BowenS123/2EAI-PEN-2526-Industry4/hardware/README.md

> [!Tip]
>
> Plaats hier **schema's, PCB's en BoM's**.
>
> Structuur: `schematics/`, `pcb/`, `bom/`, `3d/`.
>
> Noem gebruikte tools (bijv. KiCad, Eagle) in een README binnen deze map.

# Hardwareoverzicht

Dit document bevat een overzicht van de gebruikte hardwarecomponenten in dit project. Alle datasheets zijn lokaal opgeslagen in de map `../docs/datasheets/`.

## 🧩 Componentenlijst

| Componentnaam  | Functie | Fabrikant | Datasheet | More info | Supplier |
|---|---|---|---|---|---|
| VL53L0X | Afstandssensor | STMicroelectronics | [Datasheets](../docs/datasheets/) | [wiki.st.com]| [mouser]( ) |
| NEMA 17 | Stappenmotor | -- | [Datasheets](../docs/datasheets/) | -- | [mouser]( ) |
| ESP32 DevKit | Microcontroller | Espressif | [Datasheets](../docs/datasheets/) | [docs.espressif.com]() | [mouser]( ) |

## 🔌 Aansluitschema

> Voeg hier een afbeelding of diagram toe waarin de bedrading en verbindingen van de componenten worden weergegeven.

- Bestand: `./schematics/wiringschema.png`
- Alternatief: teken met [Fritzing] en exporteer als PNG/SVG.

## 📏 Specificaties en toleranties

- Voedingsspanning: 5V via USB
- Motorstroom: max. 1.2A
- Sensorbereik: 20 mm – 2000 mm (VL53L0X)
- Communicatie: I²C (3.3V-logica)

## 📦 Reserve-onderdelen en versies

- Kalibratie uitgevoerd met firmwareversie `v1.0.3`.
- ESP32 DevKit V4 (let op: oudere versies hebben andere pinout).
