BowenS123/2EAI-PEN-2526-Industry4/docs/Report turning cilinder.pdf

# Turning Modular actuator

Modular cilinder basics
Cilinder: Static Base cilinder: 40 mm diameter, 5 mm depth Cilinder: HoleStatic 25 mm diameter, 5 mm depth

// join => Staticcilinder
————————————————————————————————— StepMotor fit
Cube: StepMaxDim: width 32.1, height 22.2, depth 12.2

StepBody: Join ConnectStep & MainBodyStep : CTR+J-key => StepBody Cube: MainBodyStep: width 23, height: 22.2, depth 12.2
Cube: ConnectStep: width 32.1, height 3, depth 12.2
// connectstep 18.2 <-> 21.2 into height main body
// blender calc begin ConnectStep => 18.2/2 - 3/2 = 9.1-1.5 = 7.6 Print this to compare to stepmotor

Cilinder main
copy Staticcilinder => MotorCilinder
Pas aan properties: diameter 25 mm, hoogte 20 mm

Splits MotorCilinder in 2: Boolean delete + copy Connectie 2 objecten:
- Clilinder 1: delete
- Cilinder 2: join
Ruimte voor servo:
1. Zet alles op juiste plaats
2. Op elk opject dat servo raakt: delete boolean
