BowenS123/2EAI-PEN-2526-Industry4/docs/README.md

# Projectdocumentatie

Deze map bevat de technische documentatie, diagrammen, handleidingen,
datasheets en afbeeldingen van de Industry 4.0-installatie.

## Belangrijkste documenten

- [MQTT instellen en testen](MOSQUITTO_SETUP.md)
- [TwinCAT Vision installeren](InstallatieTCVision.md)
- [PLC-documentatie](PLC_Documentatie.md)
- [Onderdelenlijst](Bomlijst.md)
- [Bijdragen aan het project](CONTRIBUTING.md)

## Media

- `images/0_HardwareDiagram.png` — hardwarearchitectuur
- `images/0_Final_Result.drawio.png` — systeemoverzicht
- `images/Testcamera.png` — werkende QR-detectie

Gebruik in Markdown altijd relatieve paden. Nieuwe afbeeldingen krijgen een
beschrijvende naam en worden toegevoegd aan een relevante documentatiepagina.
Build-output, tijdelijke exports en persoonlijke credentials horen niet in Git.
