BowenS123/2EAI-PEN-2526-Industry4/firmware/README.md

# Firmware

De actieve firmwareprojecten staan gegroepeerd onder [`src/`](../src/):

- [`ESP_Mixer_MQTT`](../src/ESP_Mixer_MQTT/) — ESP32/PlatformIO-mixer
- [`PSOC_MQTT`](../src/PSOC_MQTT/) — PSoC6 MQTT-client
- [`RobotArm`](../src/RobotArm/) — PSoC6-robotarm en teach mode

Open elk project met de bijbehorende toolchain. Gebruik lokale configuratie-
bestanden voor WiFi- en MQTT-credentials; commit nooit echte wachtwoorden.
