BowenS123/2EAI-PEN-2526-Industry4/hardware/3Dprint/Transportband/doosje_transport.png

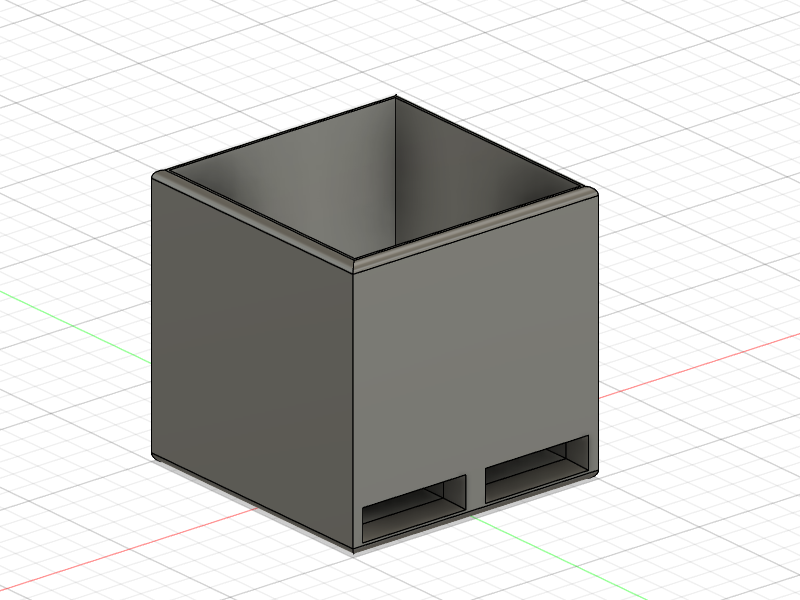
hardware/3Dprint/Transportband/doosje_transport.png
