BowenS123/2EAI-PEN-2526-Industry4/hardware/3Dprint/Transportband/schuif_proto.png

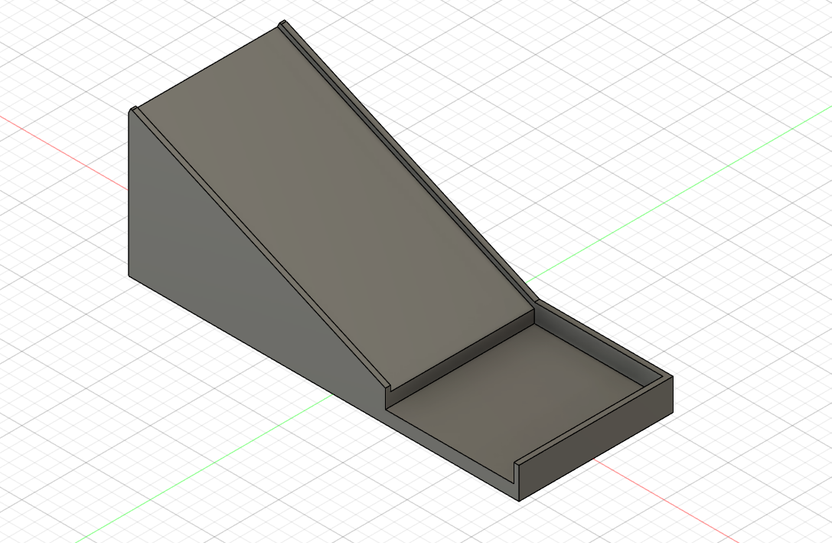
hardware/3Dprint/Transportband/schuif_proto.png
