BowenS123/2EAI-PEN-2526-Industry4/tools/stappenplan_snel.png

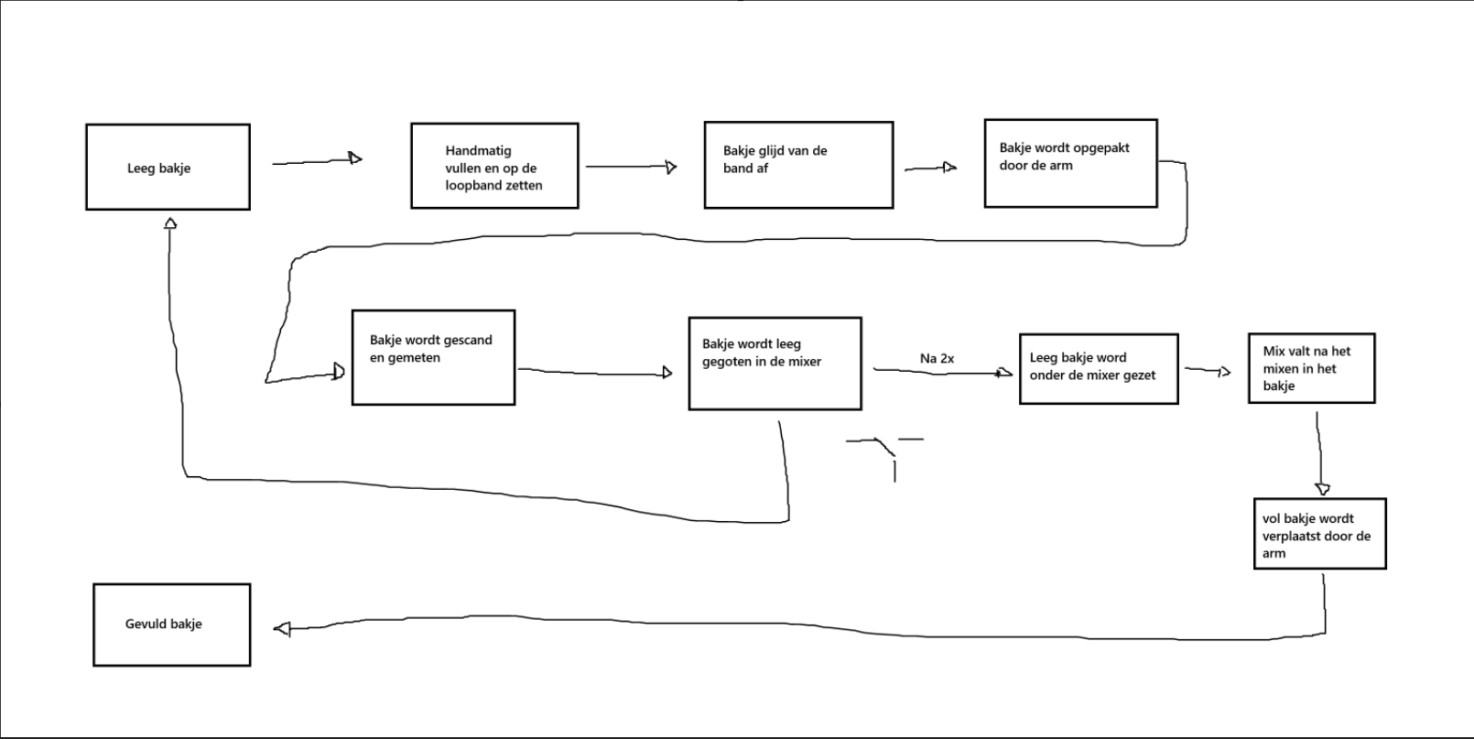
tools/stappenplan_snel.png
