BowenS123/2EAI-PEN-2526-Industry4/hardware/3Dprint/Servo/SG90 - Micro Servo 9g - Tower Pro.SLDASM

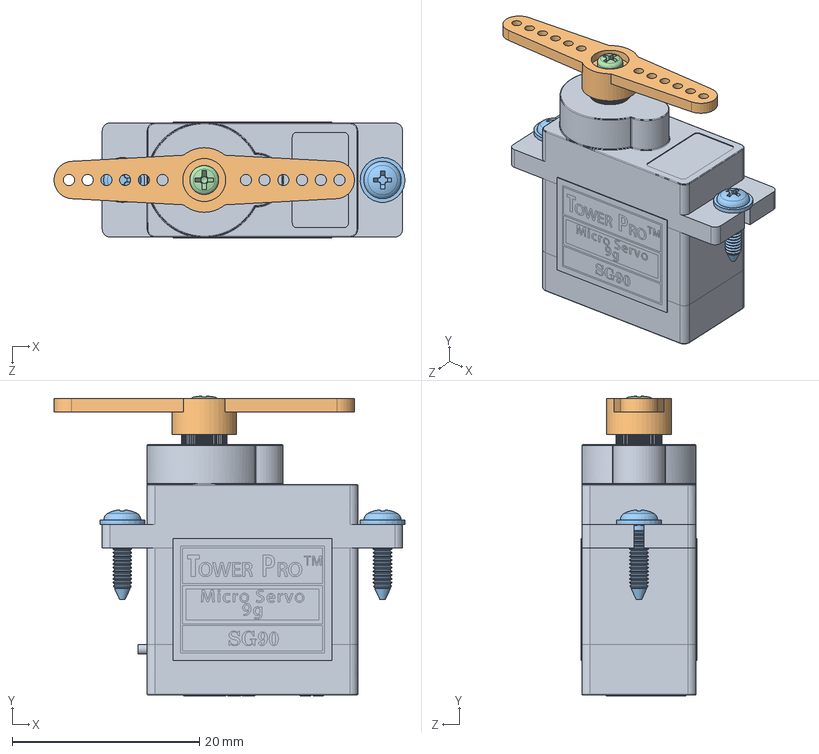
[picture p11: CAD file, 2026-06-02]
hardware/3Dprint/Servo/SG90 - Micro Servo 9g - Tower Pro.SLDASM
37.5 x 32.0 x 12.4 mm
SG90 - Micro Servo 9g - Tower Pro.1
SG90 - Micro Servo 9g - Tower Pro.3
SG90 - Micro Servo 9g - Tower Pro.5 x 2
SG90 - Micro Servo 9g - Tower Pro.6
