BowenS123/2EAI-PEN-2526-Industry4/hardware/3Dprint/Mixer/shaft DCmotor adapter LEGO .stl

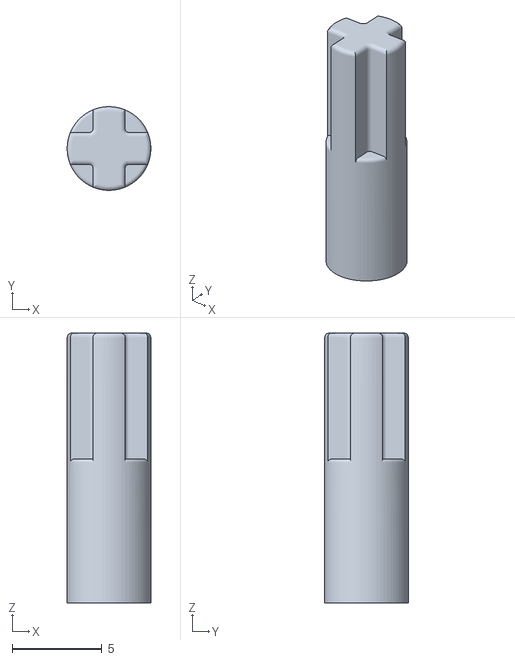
[picture p12: CAD file, 2026-06-02]
hardware/3Dprint/Mixer/shaft DCmotor adapter LEGO .stl
4.65 x 4.65 x 15.0
