BowenS123/2EAI-PEN-2526-Industry4/hardware/3Dprint/Servo/stepBody.stl

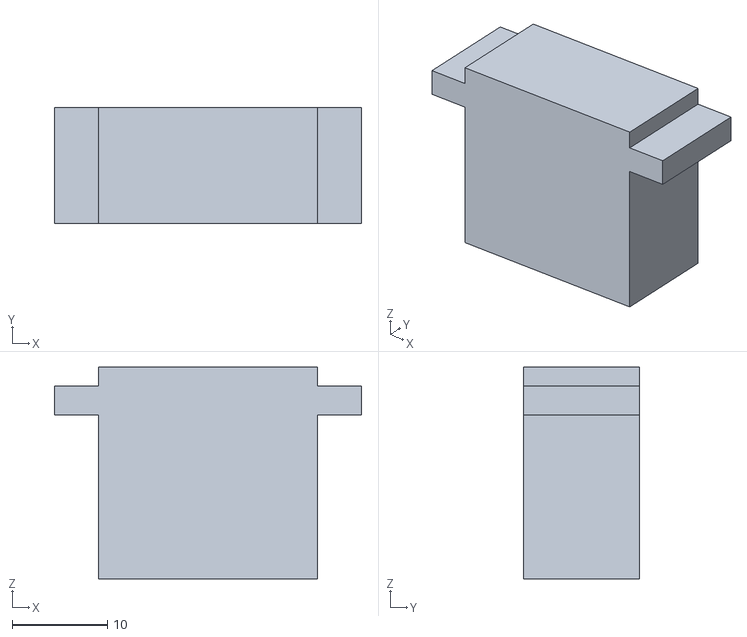
[picture p13: CAD file, 2026-06-02]
hardware/3Dprint/Servo/stepBody.stl
32.2 x 12.2 x 22.2
