BowenS123/2EAI-PEN-2526-Industry4/hardware/3Dprint/Transportband/schuif_proto.stl

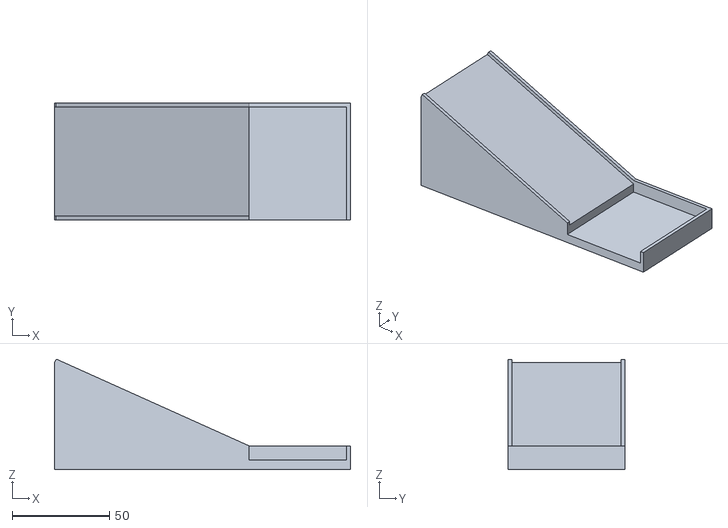
[picture p14: CAD file, 2026-06-02]
hardware/3Dprint/Transportband/schuif_proto.stl
152.0 x 60.0 x 56.6
