BowenS123/2EAI-PEN-2526-Industry4/hardware/3Dprint/Untitled_wheel-adapt_servo_DOWN.stl

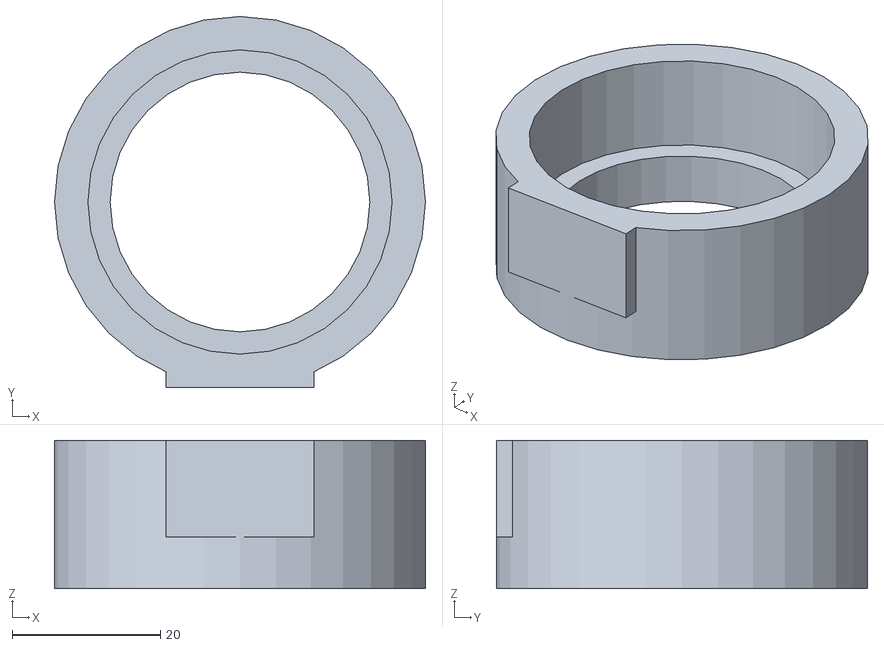
[picture p15: CAD file, 2026-06-02]
hardware/3Dprint/Untitled_wheel-adapt_servo_DOWN.stl
50.0 x 50.0 x 20.0
