BowenS123/2EAI-PEN-2526-Industry4/hardware/3Dprint/Mixer/dc adapter.stl

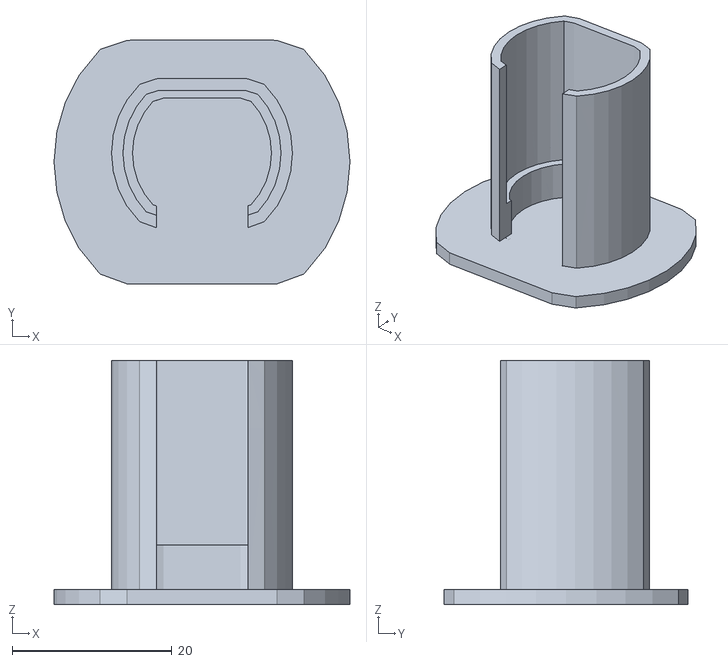
[picture p16: CAD file, 2026-06-02]
hardware/3Dprint/Mixer/dc adapter.stl
37.0 x 30.5 x 30.6
