BowenS123/2EAI-PEN-2526-Industry4/hardware/3Dprint/Servo/turn_motor_deksel.stl

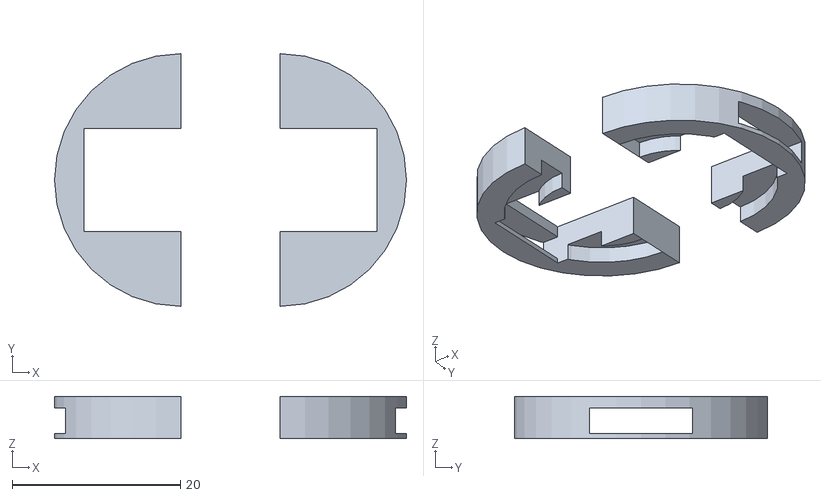
[picture p17: CAD file, 2026-06-02]
hardware/3Dprint/Servo/turn_motor_deksel.stl
41.8 x 30.0 x 5.00
