BowenS123/2EAI-PEN-2526-Industry4/hardware/3Dprint/Transportband/doosje_transport.stl

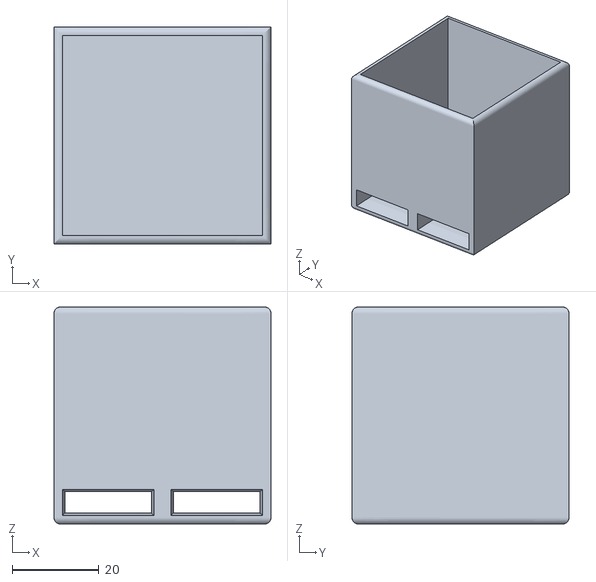
[picture p18: CAD file, 2026-06-02]
hardware/3Dprint/Transportband/doosje_transport.stl
50.0 x 50.0 x 50.0
