BowenS123/2EAI-PEN-2526-Industry4/hardware/3Dprint/Untitled_wheel-Servo_Gear.006.stl

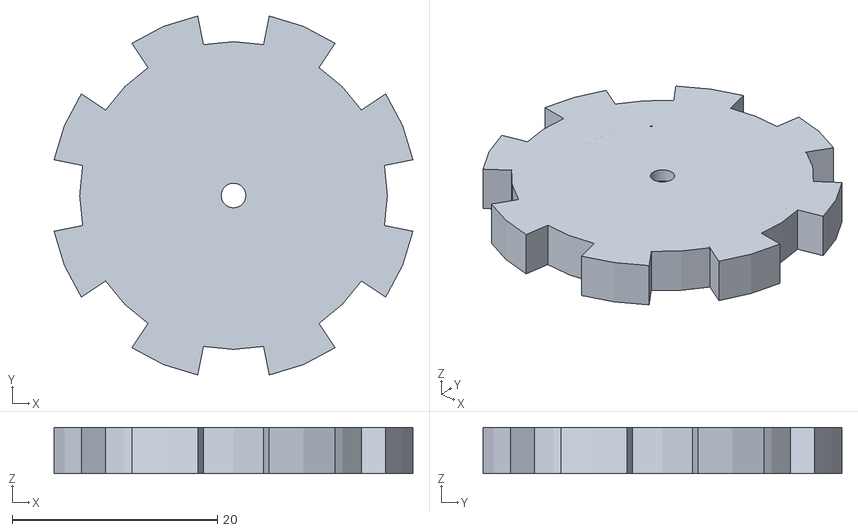
[picture p19: CAD file, 2026-06-02]
hardware/3Dprint/Untitled_wheel-Servo_Gear.006.stl
35.0 x 35.0 x 4.51
