BowenS123/2EAI-PEN-2526-Industry4/hardware/3Dprint/Mixer/cover_mixer.stl

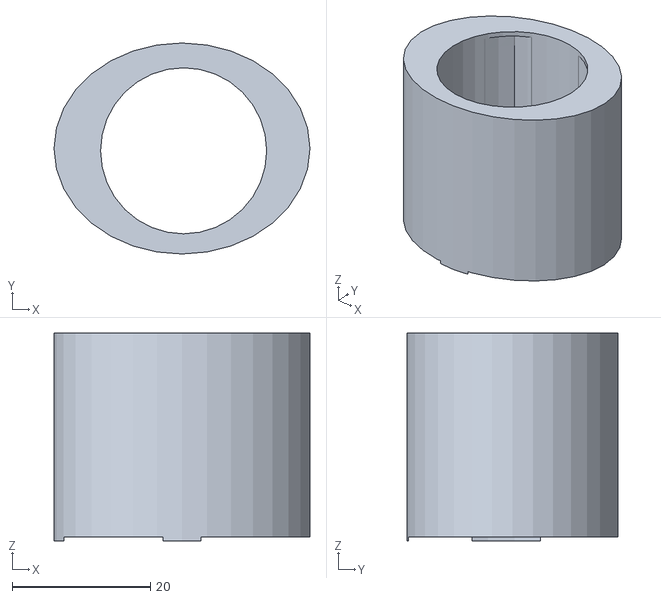
[picture p20: CAD file, 2026-06-02]
hardware/3Dprint/Mixer/cover_mixer.stl
37.0 x 30.5 x 30.0
