BowenS123/2EAI-PEN-2526-Industry4/hardware/3Dprint/Servo/SG90-Servo.stl

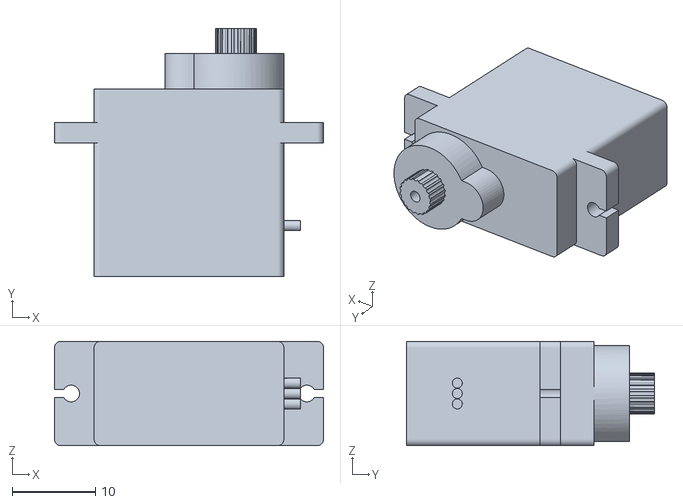
[picture p21: CAD file, 2026-06-02]
hardware/3Dprint/Servo/SG90-Servo.stl
32.2 x 29.8 x 12.5
