BowenS123/2EAI-PEN-2526-Industry4/hardware/3Dprint/Transportband/vork_of_meting.stl

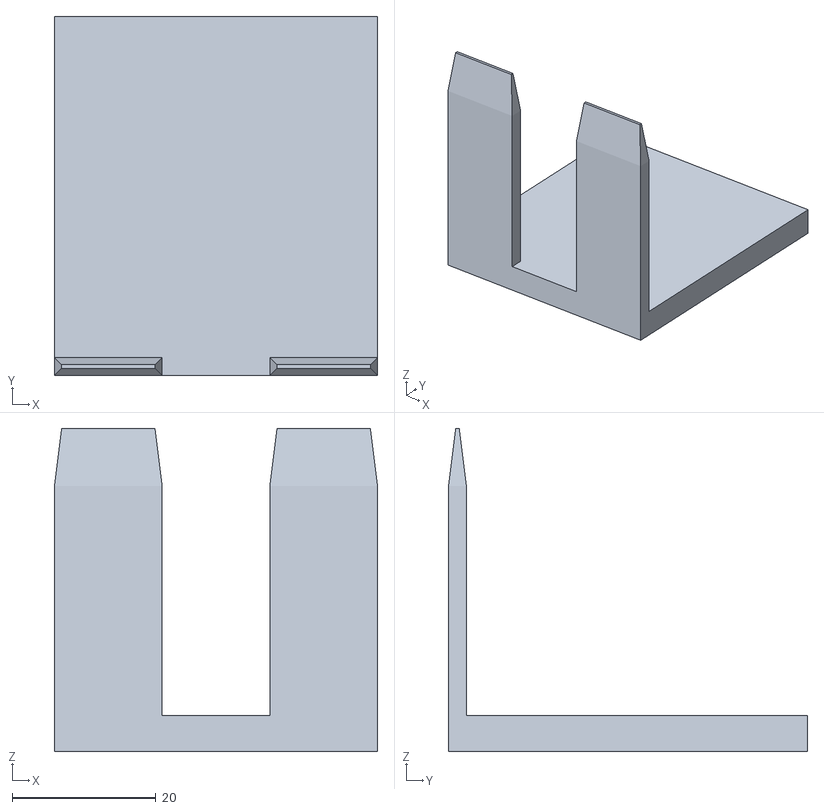
[picture p22: CAD file, 2026-06-02]
hardware/3Dprint/Transportband/vork_of_meting.stl
45.0 x 50.0 x 45.0
