BowenS123/2EAI-PEN-2526-Industry4/hardware/3Dprint/Untitled_wheel-adapt_servo_UP.stl

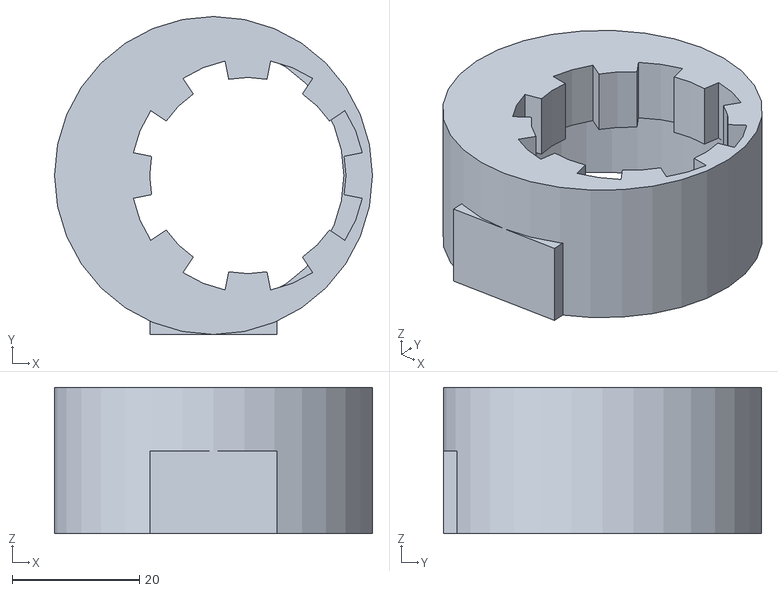
[picture p23: CAD file, 2026-06-02]
hardware/3Dprint/Untitled_wheel-adapt_servo_UP.stl
50.0 x 50.0 x 23.0
