BowenS123/2EAI-PEN-2526-Industry4/hardware/3Dprint/Servo/turn_motor.stl

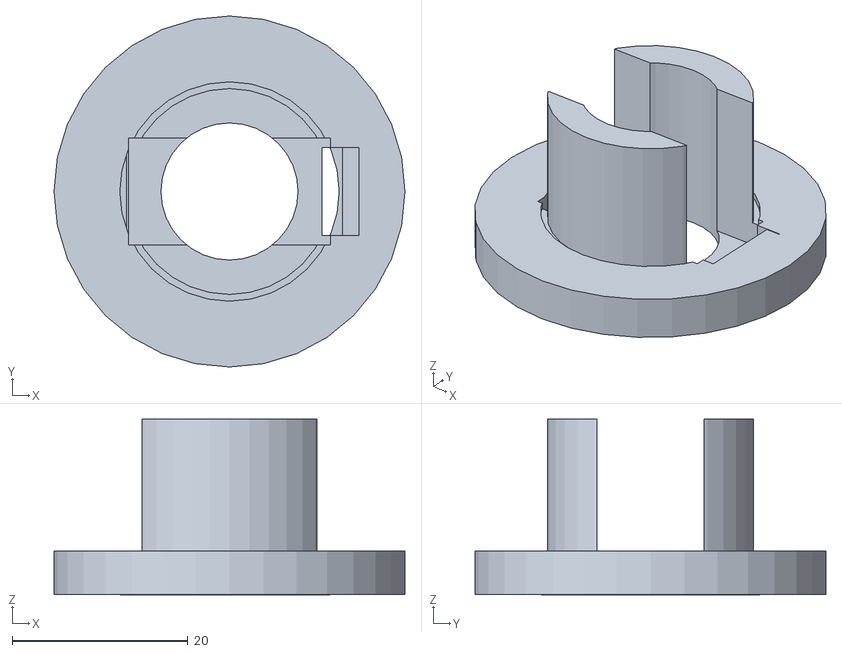
[picture p24: CAD file, 2026-06-02]
hardware/3Dprint/Servo/turn_motor.stl
40.0 x 40.0 x 20.0
