BowenS123/2EAI-PEN-2526-Industry4/hardware/3Dprint/Transportband/Fork_proto.stl

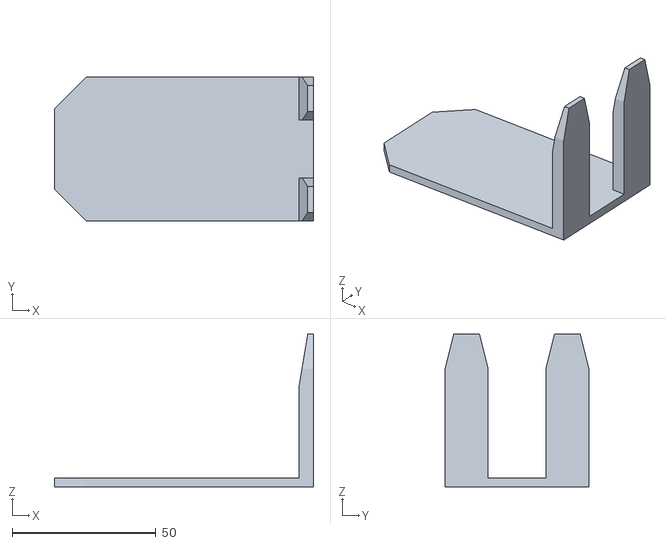
[picture p25: CAD file, 2026-02-09]
hardware/3Dprint/Transportband/Fork_proto.stl
90.0 x 50.0 x 53.0
