BowenS123/2EAI-PEN-2526-Industry4/hardware/3Dprint/Servo/adapter_servo._turn.stl

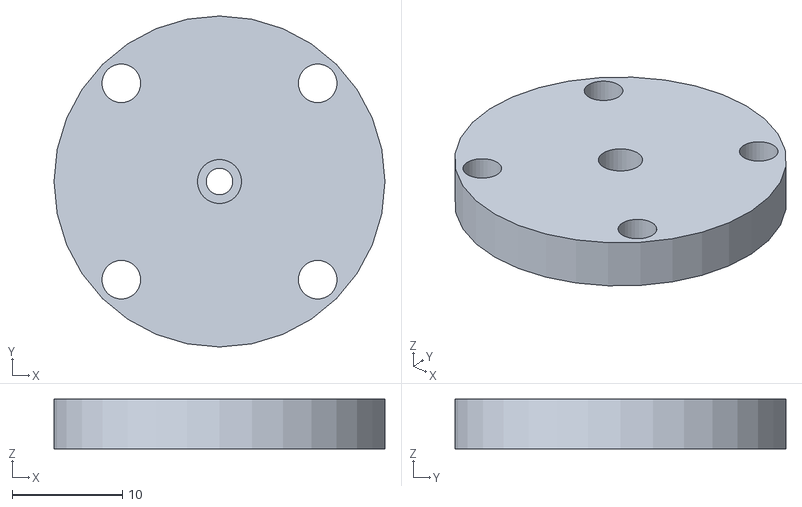
[picture p26: CAD file, 2026-06-02]
hardware/3Dprint/Servo/adapter_servo._turn.stl
30.0 x 30.0 x 4.50
