BowenS123/2EAI-PEN-2526-Industry4/src/ESP_Mixer_MQTT/src/config.example.h

#ifndef INDUSTRY4_CONFIG_EXAMPLE_H
#define INDUSTRY4_CONFIG_EXAMPLE_H

// Copy this file to config.h and replace the placeholders locally.
// config.h is ignored by Git and must never contain committed credentials.
#define WIFI_SSID "your-wifi-ssid"
#define WIFI_PASSWORD "your-wifi-password"

#define MQTT_SERVER "192.168.1.240"
#define MQTT_PORT 1883

#endif
