BowenS123/2EAI-PEN-2526-Industry4/(commit log)

2026-02-09 Datasheet motor + driver
2026-02-09 Add pigtail connectors to the Hardware List in the README
2026-02-09 Add files via upload
    Prototype voor de vorken in fushion
    [Fork_proto.stl]
2026-02-09 Snel stappenplan van het proces
2026-02-16 Deleted outdated files
    [Fork_proto.stl]
2026-02-16 New 3D files met juiste afmeting (proto)
    [doosje_transport.stl, schuif_proto.stl, vork_of_meting.stl]
2026-02-16 Add TwinCAT PLC project for PannenkoekSysteem
    Add a new TwinCAT PLC solution and project for the PannenkoekSysteem. Files added include the .sln and .tsproj, PLC project files, boot/port artifacts, library references and compile info. Implements basic PLC sources: DUT E_MainState, GVLs (Config/Data/Inputs/Outputs), POUs (FB_StateMachine, FB_Transportband, MAIN) and a PlcTask; FB_StateMachine contains a simple start/stop/error state machine and FB_Transportband simulates a conveyor using a TON timer. This provides the initial project structure and basic runtime logic for the system.
2026-02-18 Create turn_motor.blend
    corrections and upload .blend
    [turn_motor.blend]
2026-02-23 adapt for scews ~2mm thinner body
    [turn_motor.blend, turn_motor.stl, turn_motor_deksel.stl]
2026-02-23 Bomlijst voor onderdelen
    een layout voor onze onderdelen aankopen
2026-02-23 Add Bill of Materials document (Bomlijst.md)
    Add a new BOM for the "Geautomatiseerde Productielijn" (version 1.0) at docs/Bomlijst.md. The file provides sections for mechanical components, sensors, control & electronics, subsystems, cost summary, purchase status, and notes. Several specific part entries include supplier links (RS PRO motor, igus steppers/drivers, Beckhoff EtherCAT terminals), while many fields (prices, vendors, dates) remain marked TBD or placeholders.
2026-02-24 toevoegen adapter voor servo naar fork...
    [adapter_servo._turn.stl]
2026-03-02 Update motor control and button ISR in README
    Refactor motor control logic and button handling in main function.
2026-03-02 Test file timer based
    Test file om de richting van de moto te testen op basis van tijd
2026-03-09 Add Wi-Fi MQTT Client PSoC example
    Add complete Wi‑Fi MQTT Client example for PSoC (PSOC_MQTT/Wi‑Fi_MQTT_Client). Includes source code (main, mqtt/publisher/subscriber tasks, heap usage), configuration headers, mbedTLS/mqtt/wifi dependencies, images, project metadata and many target-specific linker templates. Also add tooling files (.clang-format, .clangd, .mtb-prefs.json), a comprehensive .gitignore, and build artifacts (Makefile, .ninja_log, deps). This brings the full example project and board/toolchain templates into the repository for developers to build and run on supported targets.
2026-03-09 Update MQTT client config and tasks
    add robot arm communication via psoc6
    when mixer is done it will automatically activate robot arm
2026-03-09 Add TwinCAT PLC project and solution for MQTT_PLC
    Introduce a new TwinCAT PLC workspace for MQTT_PLC: adds Visual Studio solution (.sln), PLC project (.tsproj) and backup, user/project settings (.suo, .project.~u), compile info and boot/target files. The project defines a PLC instance (MQTT_PLC_TEST) with task configuration (PlcTask, Ams port 851) and EtherCAT IO layout (EK1200, EL1008, EL2008, EL3062, EL4002, EK1110), including PDO/FMMU mappings and image data. These files set up the device/IO configuration and boot package required to deploy the PLC for MQTT integration testing.
2026-03-14 Verbeter code MQTT + integratie device working (device_function) + update paden
    -> niet luisteren naar stap 7 (robotarm)
    -> Description post "mydata/robot/description"
    -> Reset functie: "mydata/robot/description"
    -> GET 6 = 1 => device executie => POST 7 = 1
    [device_function.c, device_function.h, main.c, mqtt_client_config.c, mqtt_client_config.h, publisher_task.c, publisher_task.h, subscriber_task.c]
2026-03-15 Add MQTT PLC test projects and Wi‑Fi MQTT client
    Add complete MQTT PLC test project tree (POUs, VISUs, compile info, libraries and TwinCAT boot artifacts) and many compiled library files; remove obsolete MQTT_PLC.project.~u. Update MQTT_PLC.tsproj to mark BIT array types explicitly, set TargetNetId/Target64Bit, add TmcPath/TmcHash for the PLC instance, and disable/retarget the IO device AmsNetId. Also add a new src/Wi-Fi_MQTT_Client sample with build templates, configs, source files and documentation.
2026-03-16 Totaal plaatje van de aandrijf as
    [Aandrijfrol.ipt]
2026-03-16 arm schets & notities
2026-03-16 Servo and Steppen motor code
2026-03-16 Meerdere steppers laten werken
2026-03-16 Twincat visi installatie geprobeerd
    toegevoeg twincat visi lib en beckhoff pc bedraad en camera toegevoegd met ethernet poort. uit zoeken hoe we twincat visie installeren
2026-03-20 Toevoegen van device functions
    Device functions toegevoegd van milan
2026-03-20 ESP_Mixer naar json formaat
    Veranderd naar json formaat.
    topics veranderd naar pancake/mixer/cmd
    pancake/mixer/state
    pancake/mixer/error
    pancake/mixer/status
    MQTT server locatie veranderd naar ip = 192.168.1.240 van laptop
    [MQTTManager.cpp, MQTTManager.h, main.cpp]
2026-03-21 Parse functies en mixer toegevoegd + visu update
    parse functie toegevoeg om via visu mooier te laten weergeven en mixer toegevoegd aan de visu
2026-03-23 Add Instellingen
    Arm instellingen en pin-out toegevoegd
2026-03-30 vizualisatie gemaakt voor de Transportband
2026-03-30 Remove ESP32 docs URL from hardware README
    Replaced the Espressif documentation URL in the ESP32 DevKit row of hardware/README.md with an empty link placeholder ([docs.espressif.com]()). This removes the direct external link from the hardware table (can be updated with a correct URL later).
2026-03-30 Fix error (#7)
    * Update CONTRIBUTING.md
    * Remove ESP32 docs URL from hardware README
    * Replace .docx docs with PDFs
    Remove Word (.docx) sources and add PDF exports for two documents: docs/Linear_actuator adapters 3D and docs/Stepmotor_lab. This commit converts the delivered documentation to PDF format for distribution; no other content changes were made.
    * Move PDFs into docs/datasheets
    Relocate two PDF datasheets into the docs/datasheets di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
2026-04-18 documentatie weegschaal + HW Mixer
    [cover_mixer.stl, dc adapter.stl, mixermotor adapter.stl]
2026-04-20 as voor motor 3D
    [rolband_as_motor.stl]
2026-04-20 Add ProjectTest1 for motor control and Capsense
2026-04-20 toevoeging data sheets
    C6015 beckhoff industrial pc en Mako G-040 camera voor night vision datasheet
2026-04-23 Update TwinCAT project and add QR reader
    Camera-input op Mono8/grayscale.
    Ruwe liveweergave toegevoegd via ipImageInDisp zodat je het originele beeld ziet.
    QR-detectie met F_VN_ReadQRCodeExp op de Mono8 bronimage.
    Adaptieve multi-pass QR-zoekstrategie toegevoegd met 3 pogingen:
    Normale polariteit en normale oriëntatie.
    Inverted polariteit toegelaten.
    Flipped oriëntatie toegelaten.
    QR-resultaatcontainers worden per frame gereset (ipCodeDecodedList := 0, ipCodeContourList := 0) om oude data te voorkomen.
    Bij succesvolle detectie wordt de QR-tekst geëxporteerd naar string (sCodeAsString).
    Voor visuele overlay wordt Mono8 omgezet naar RGB (TCVN_CST_GRAY_TO_RGB), zodat kleur mogelijk is.
    QR-co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
2026-04-27 Update voltage and amperage notes in BestelLijst.md
2026-04-28 gear voor servo op robotarm (printed) + concept omhulsel
    [Fork_proto.stl, SG90 - Micro Servo 9g - Tower Pro.SLDASM, SG90-Servo.stl, Untitled_wheel-Adapt_servo_out.stl, Untitled_wheel-Servo_Gear.006.stl, adapter_servo._turn.stl, cover_mixer.stl, dc adapter.stl]
2026-05-03 servo adapter KONG STRONG
    [Untitled_wheel-Adapt_servo_out.stl, Untitled_wheel-adapt_servo_DOWN.stl, Untitled_wheel-adapt_servo_UP.stl]
2026-05-04 Add Robot Arm MQTT integration and RobotArm module
    Integrate Robot Arm support via MQTT and add a RobotArm example module. Changes include: GVL_MQTT extended with new topics/flags/status variables (cmd, state, error, heartbeat) and VISU controls; GlobalTextList updated with UI strings for robot/heartbeat/status; FB_MQTT updated to subscribe/publish robot topics, build command payloads (teach/goto/save/stop), parse incoming state/error/heartbeat messages, and run a heartbeat watchdog; MAIN updated to expose VISU taps, combine commands, update robot status display and forward commands to fbMqtt; many TwinCAT project/compile info and register entries updated; removed a user file and added LineI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
    [device_function.c, device_function.h, main.c, mqtt_client_config.c, mqtt_client_config.h, publisher_task.c, publisher_task.h, subscriber_task.c]
2026-05-08 Update PLC project, MQTT config, docs and RobotArm code
    Remove obsolete doc images and add comprehensive PLC_Documentatie.md; update TwinCAT PLC project files to a new TargetNetId and adjust project instance hashes. Disable Vision app and RT‑Ethernet device entries in the .tsproj, update compile/meta files and trial license/boot artifacts. Change GVL_MQTT product version and default broker IP to 192.168.0.198. Add multiple UI text entries in GlobalTextList for MQTT/robot commands and statuses. Apply edits to RobotArm MQTT/client sources and headers (mqtt_client_config.h, device_function.c, publisher/subscriber tasks) to reflect updated MQTT configuration and behavior.
    [device_function.c, mqtt_client_config.h, publisher_task.c, publisher_task.h, subscriber_task.c, subscriber_task.h]
2026-05-18 Inductieve sensor datascheet
2026-05-31 PLC update
    automatische instellingen
    motor van transportband parameters
2026-05-31 datasheet motor transportband
    toegevoegd datasheet transportband motor
2026-06-02 Development part2 (#11)
    * documentatie weegschaal + HW Mixer
    * commit lost files
    * commit lost plc code
    * toevoeging data sheets
    * Add TC Vision docs and reorganize PLC tests
    Add full TC Vision installation guide (docs/InstallatieTCVision.md) and include accompanying screenshots under docs/ and docs/images/. Reorganize test project layout by moving MQTT_PLC test files up one directory level (renames under tests/PLC/) and remove obsolete Vision_PLC solution/.suo entries. Also add tests/PLC/TwincatVisionTest.tnzip.
    * Update TwinCAT project and add QR reader
    Ruwe liveweergave t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
    [Fork_proto.stl, SG90 - Micro Servo 9g - Tower Pro.SLDASM, SG90-Servo.stl, Untitled_wheel-Servo_Gear.006.stl, Untitled_wheel-adapt_servo_DOWN.stl, Untitled_wheel-adapt_servo_UP.stl, adapter_servo._turn.stl, cover_mixer.stl]
